independence121/altimeterv1/borealis_altimeter/borealis_altimeter.kicad_pcb

## KiCad design borealis_altimeter/borealis_altimeter.kicad_pcb (2026-05-01)

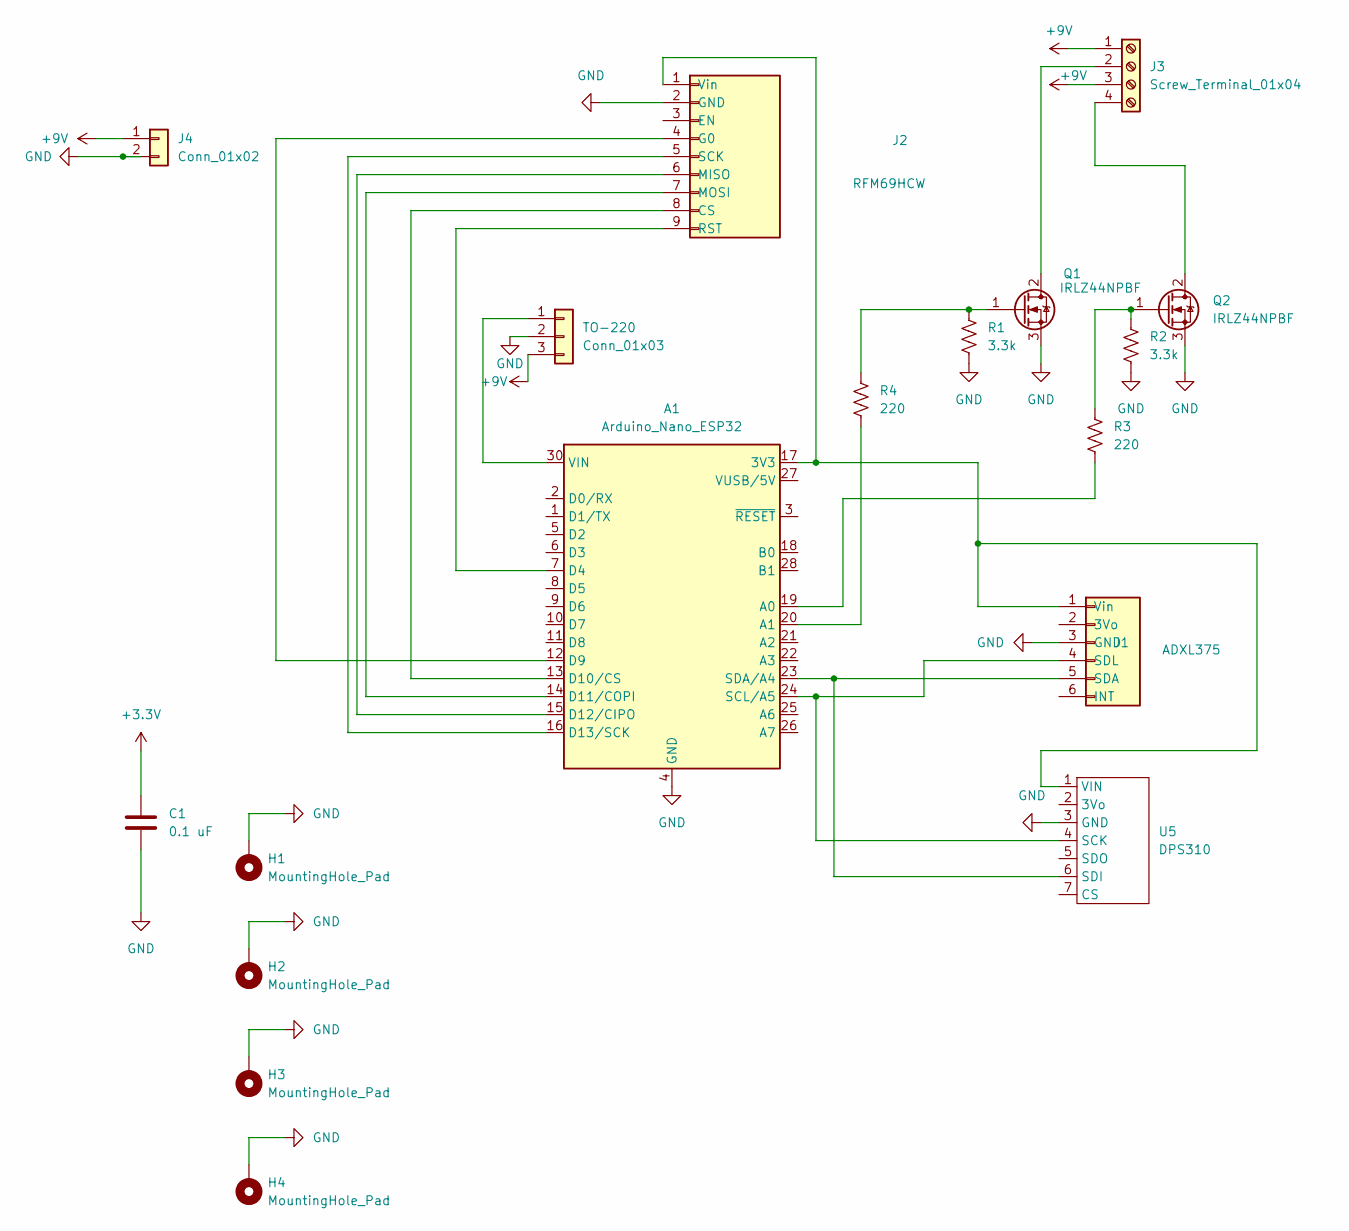
[picture p1: schematic borealis_altimeter.kicad_sch, SRAD Altimeter]

Parts:
A1: Arduino_Nano_ESP32; Arduino_Nano
C1: 0.1 uF; C_1206_3216Metric_Pad1.33x1.80mm_HandSolder
H1, H2, H3, H4: MountingHole_Pad; MountingHole_3.2mm_M3_Pad
J1: ADXL375; PinSocket_1x06_P2.54mm_Vertical
J2: RFM69HCW; PinSocket_1x09_P2.54mm_Vertical
J3: Screw_Terminal_01x04; TerminalBlock_Xinya_XY308-2.54-4P_1x04_P2.54mm_Horizontal
J4: Conn_01x02; JST_XH_B2B-XH-AM_1x02_P2.50mm_Vertical
Q1, Q2: IRLZ44NPBF; TO-220-3_Vertical
R1, R2: 3.3k; R_1210_3225Metric
R3, R4: 220; R_1210_3225Metric
TO-220: Conn_01x03; PinSocket_1x03_P2.54mm_Vertical
U5: DPS310; PinSocket_1x07_P2.54mm_Vertical

Connections:
+3.3V: C1.1
+9V: J3.1, J3.3, J4.1, TO-220.3
GND: A1.4 (GND), A1.29 (GND), C1.2, H1.1, H2.1, H3.1, H4.1, J1.3 (GND), J2.2 (GND), J4.2, Q1.3 (S), Q2.3 (S), R1.2, R2.2, TO-220.2, U5.3 (GND)
unnamed: A1.17 (3V3), J1.1 (Vin), J2.1 (Vin), U5.1 (VIN)
unnamed: A1.19 (A0), R3.1
unnamed: A1.20 (A1), R4.1
unnamed: A1.7 (D4), J2.9 (RST)
unnamed: A1.12 (D9), J2.4 (G0)
unnamed: A1.13 (D10/CS), J2.8 (CS)
unnamed: A1.14 (D11/COPI), J2.7 (MOSI)
unnamed: A1.15 (D12/CIPO), J2.6 (MISO)
unnamed: A1.16 (D13/SCK), J2.5 (SCK)
unnamed: A1.24 (SCL/A5), J1.4 (SDL), U5.4 (SCK)
unnamed: A1.23 (SDA/A4), J1.5 (SDA), U5.6 (SDI)
unnamed: A1.30 (VIN), TO-220.1
unnamed: J3.2, Q1.2 (D)
unnamed: J3.4, Q2.2 (D)
unnamed: Q1.1 (G), R1.1, R4.2
unnamed: Q2.1 (G), R2.1, R3.2

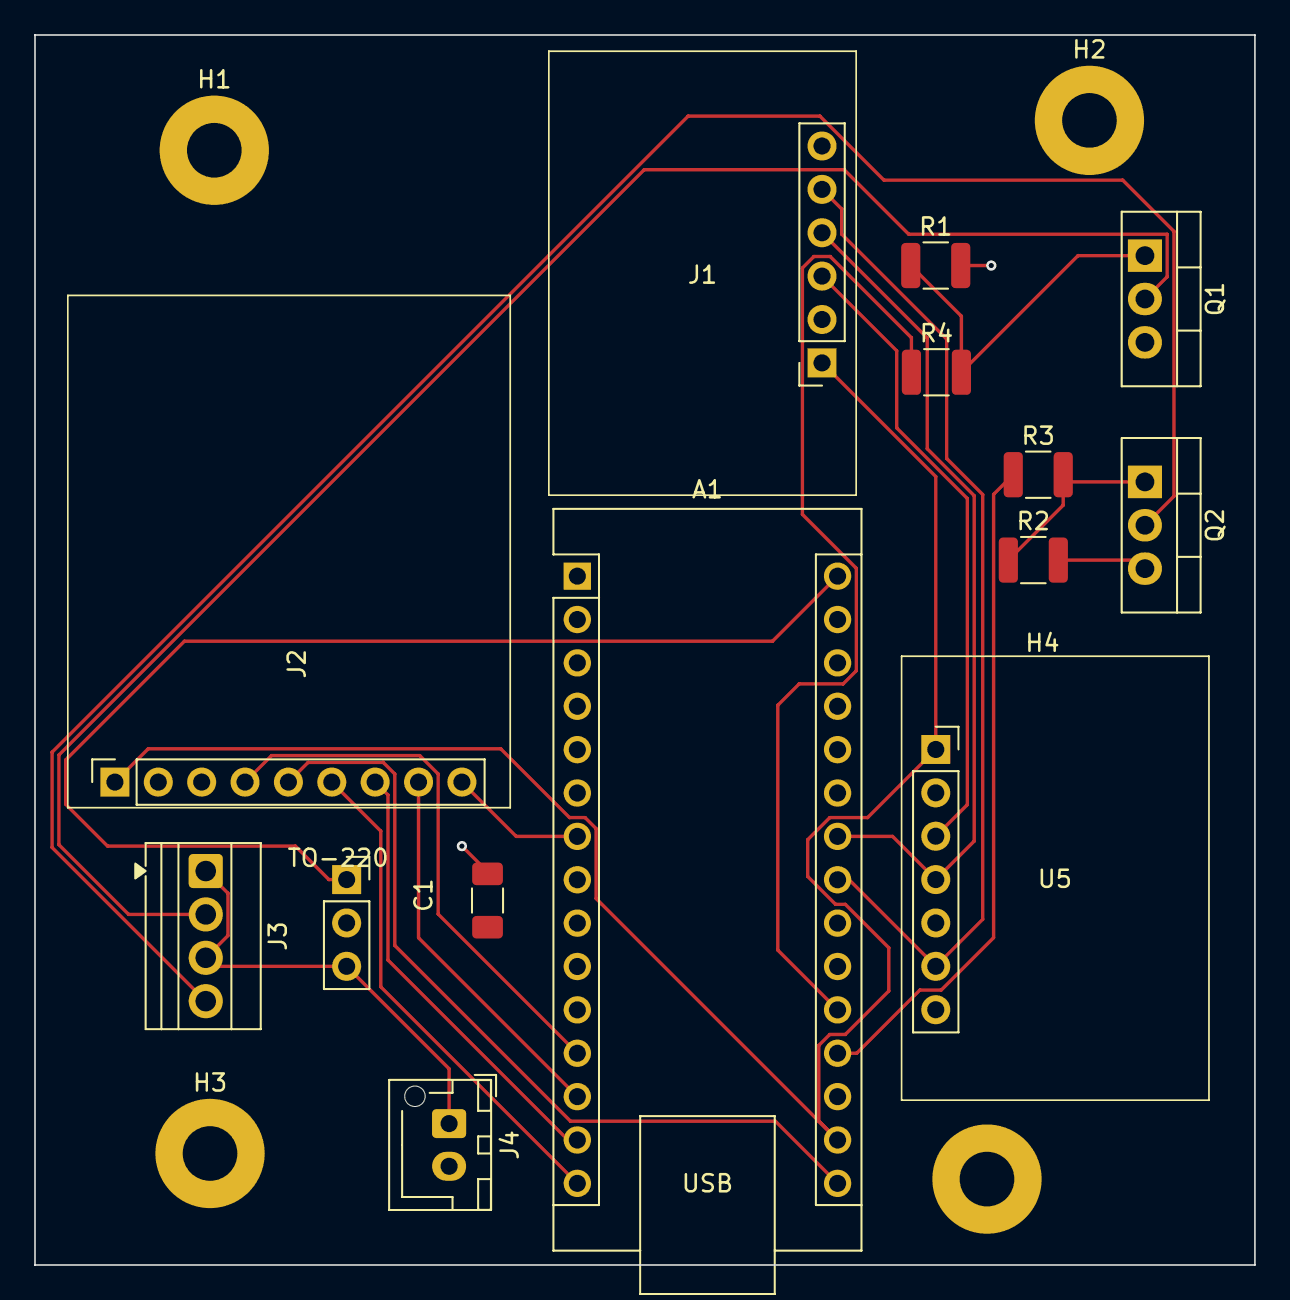
[picture p2: board borealis_altimeter.kicad_pcb from above]

Board: 2 copper layers, 71.4 x 72.0 mm, 18 parts (0 on the bottom side), 18 nets.
