independence121/altimeterv1/(commit log)

2026-03-02 removed gps
    [testkicad.kicad_sch]
2026-03-04 added radio module
    [testkicad.kicad_sch]
2026-03-04 changed out transistors
    [testkicad.kicad_sch]
2026-03-04 updated footprints
    [testkicad.csv, testkicad.kicad_pcb, testkicad.kicad_sch]
2026-03-04 footprint updates
    [testkicad.kicad_sch]
2026-03-04 the footprints have no errorsgit add .!
    [testkicad.kicad_pcb, testkicad.kicad_sch]
2026-03-06 resistors on schematic lol
    [testkicad.kicad_sch]
2026-03-10 jst connector and voltage regulator -- use 2s 7.4v battery
    [testkicad.kicad_pcb, testkicad.kicad_sch]
2026-03-10 module sizes
    [sizes.ods]
2026-03-11 organized pcb layout
    [testkicad.kicad_pcb]
2026-03-11 added traces
    [testkicad.kicad_pcb]
2026-03-12 ground plane
    [testkicad.kicad_pcb]
2026-03-19 v1 of the pcb should be ready for printing???
    [testkicad.kicad_pcb, testkicad.kicad_sch]
2026-03-23 small corrections to pcb
    [testkicad.kicad_pcb]
2026-03-23 attempting to make gerber files
    [testkicad-NPTH.drl, testkicad-PTH.drl]
2026-03-23 gerber file attempts continue
    [testkicad-B_Cu.gbr, testkicad-B_Mask.gbr, testkicad-B_Paste.gbr, testkicad-B_Silkscreen.gbr, testkicad-Edge_Cuts.gbr, testkicad-F_Cu.gbr, testkicad-F_Mask.gbr, testkicad-F_Paste.gbr]
2026-03-23 fixed traces yikes
    [testkicad.kicad_pcb]
2026-03-23 just cleaning up
    [testkicad-B_Cu.gbr, testkicad-B_Mask.gbr, testkicad-B_Paste.gbr, testkicad-B_Silkscreen.gbr, testkicad-Edge_Cuts.gbr, testkicad-F_Cu.gbr, testkicad-F_Mask.gbr, testkicad-F_Paste.gbr]
2026-03-23 final gerber file
    [testkicad-B_Cu.gbr, testkicad-B_Mask.gbr, testkicad-B_Paste.gbr, testkicad-B_Silkscreen.gbr, testkicad-Edge_Cuts.gbr, testkicad-F_Cu.gbr, testkicad-F_Mask.gbr, testkicad-F_Paste.gbr]
2026-04-14 fixed i2c for adxl
    [testkicad.kicad_pcb, testkicad.kicad_sch]
2026-04-20 updated radio schematic + renamed
    [borealis_altimeter-B_Cu.gbr, borealis_altimeter-B_Mask.gbr, borealis_altimeter-B_Paste.gbr, borealis_altimeter-B_Silkscreen.gbr, borealis_altimeter-Edge_Cuts.gbr, borealis_altimeter-F_Cu.gbr, borealis_altimeter-F_Mask.gbr, borealis_altimeter-F_Paste.gbr]
2026-04-20 pcb v2
    [borealis_altimeter.kicad_pcb]
2026-04-20 small cleanup
    [borealis_altimeter.kicad_pcb]
2026-04-28 schematic names
    [borealis_altimeter.kicad_sch]
2026-05-01 unstaged changes
    [borealis_altimeter-B_Cu.gbr, borealis_altimeter-B_Mask.gbr, borealis_altimeter-B_Paste.gbr, borealis_altimeter-B_Silkscreen.gbr, borealis_altimeter-Edge_Cuts.gbr, borealis_altimeter-F_Cu.gbr, borealis_altimeter-F_Mask.gbr, borealis_altimeter-F_Paste.gbr]
2026-05-21 new filtering logic for barometer
2026-05-21 variable time for velocity calculation
